huulanka/wisp/hardware/kicad/wisp.kicad_pcb

## KiCad design hardware/kicad/wisp.kicad_pcb (2026-08-08)

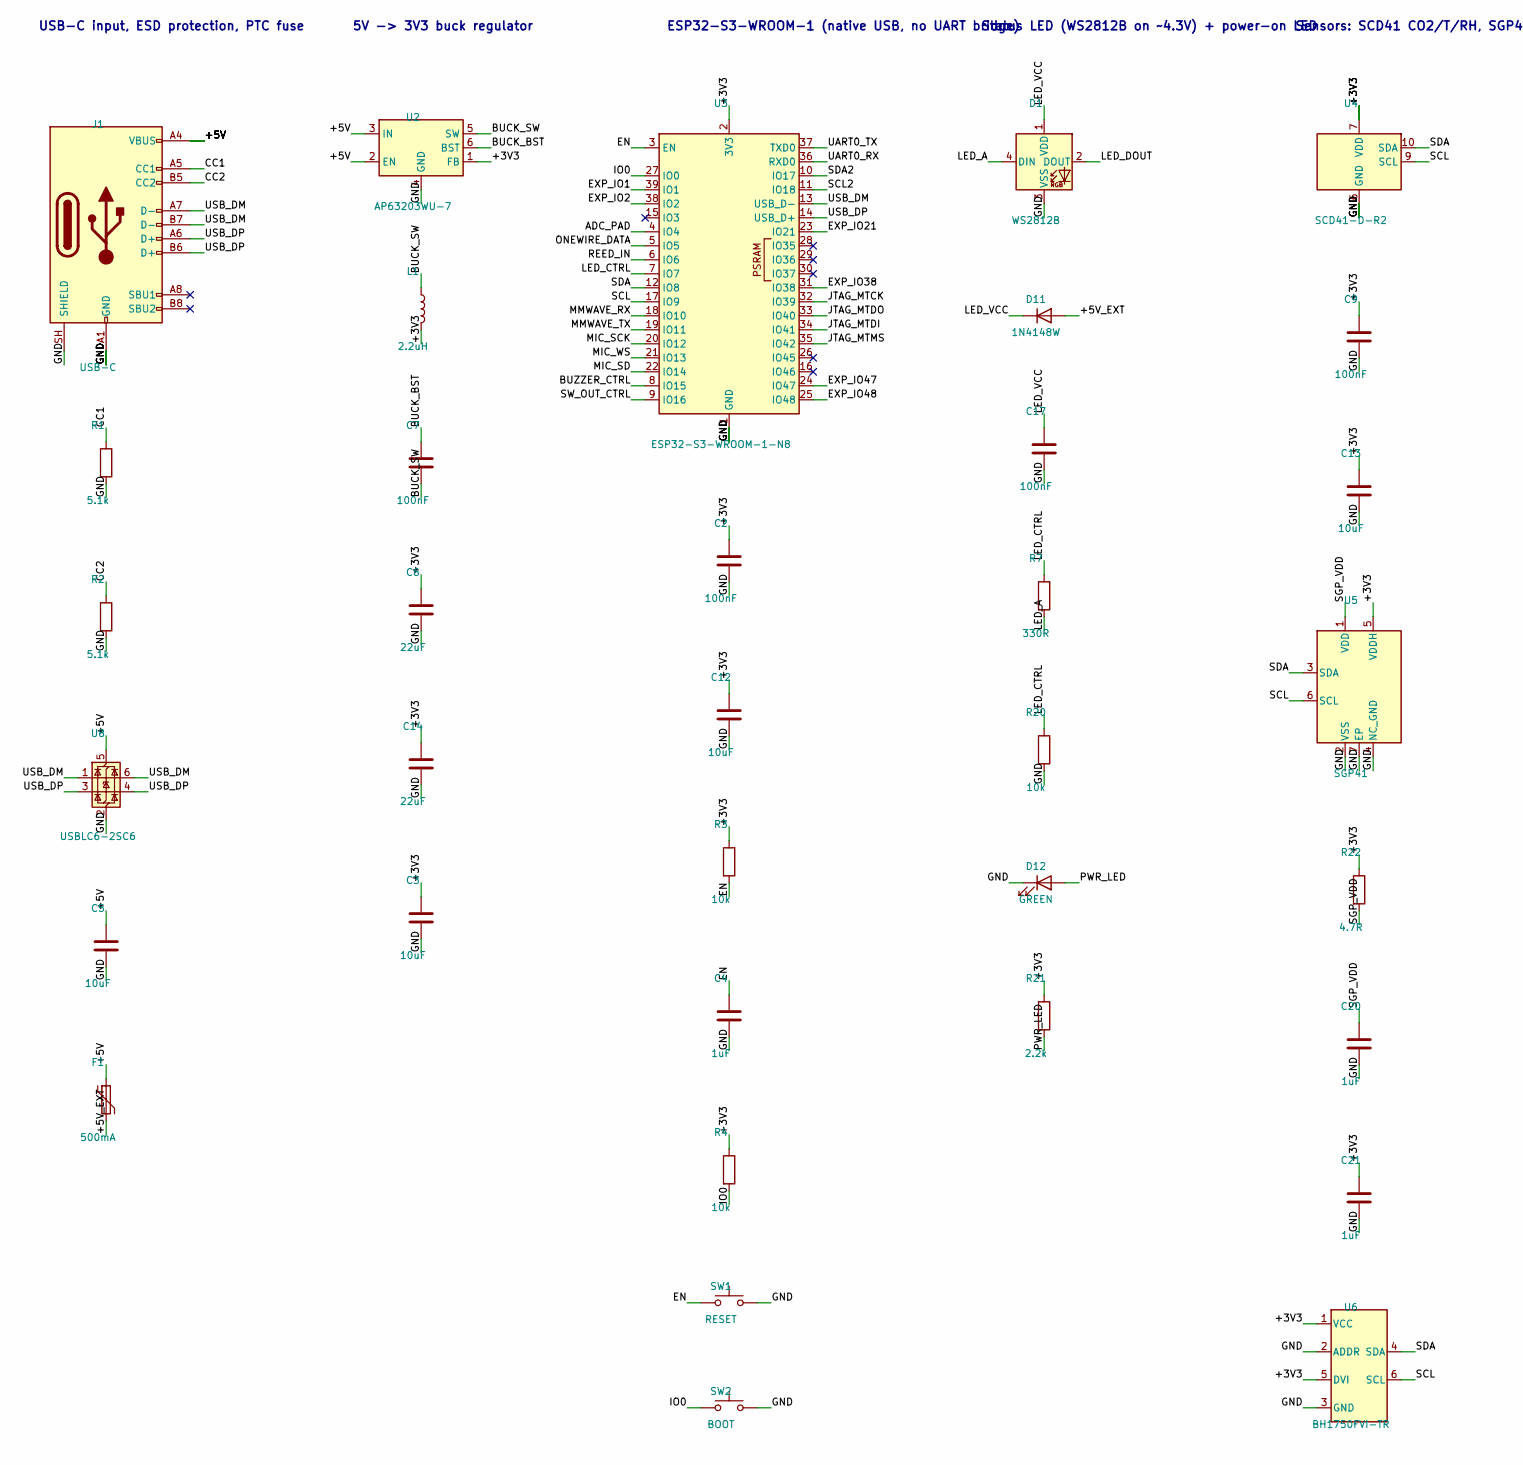
[picture p1: schematic wisp.kicad_sch, part in row 1, column 1]

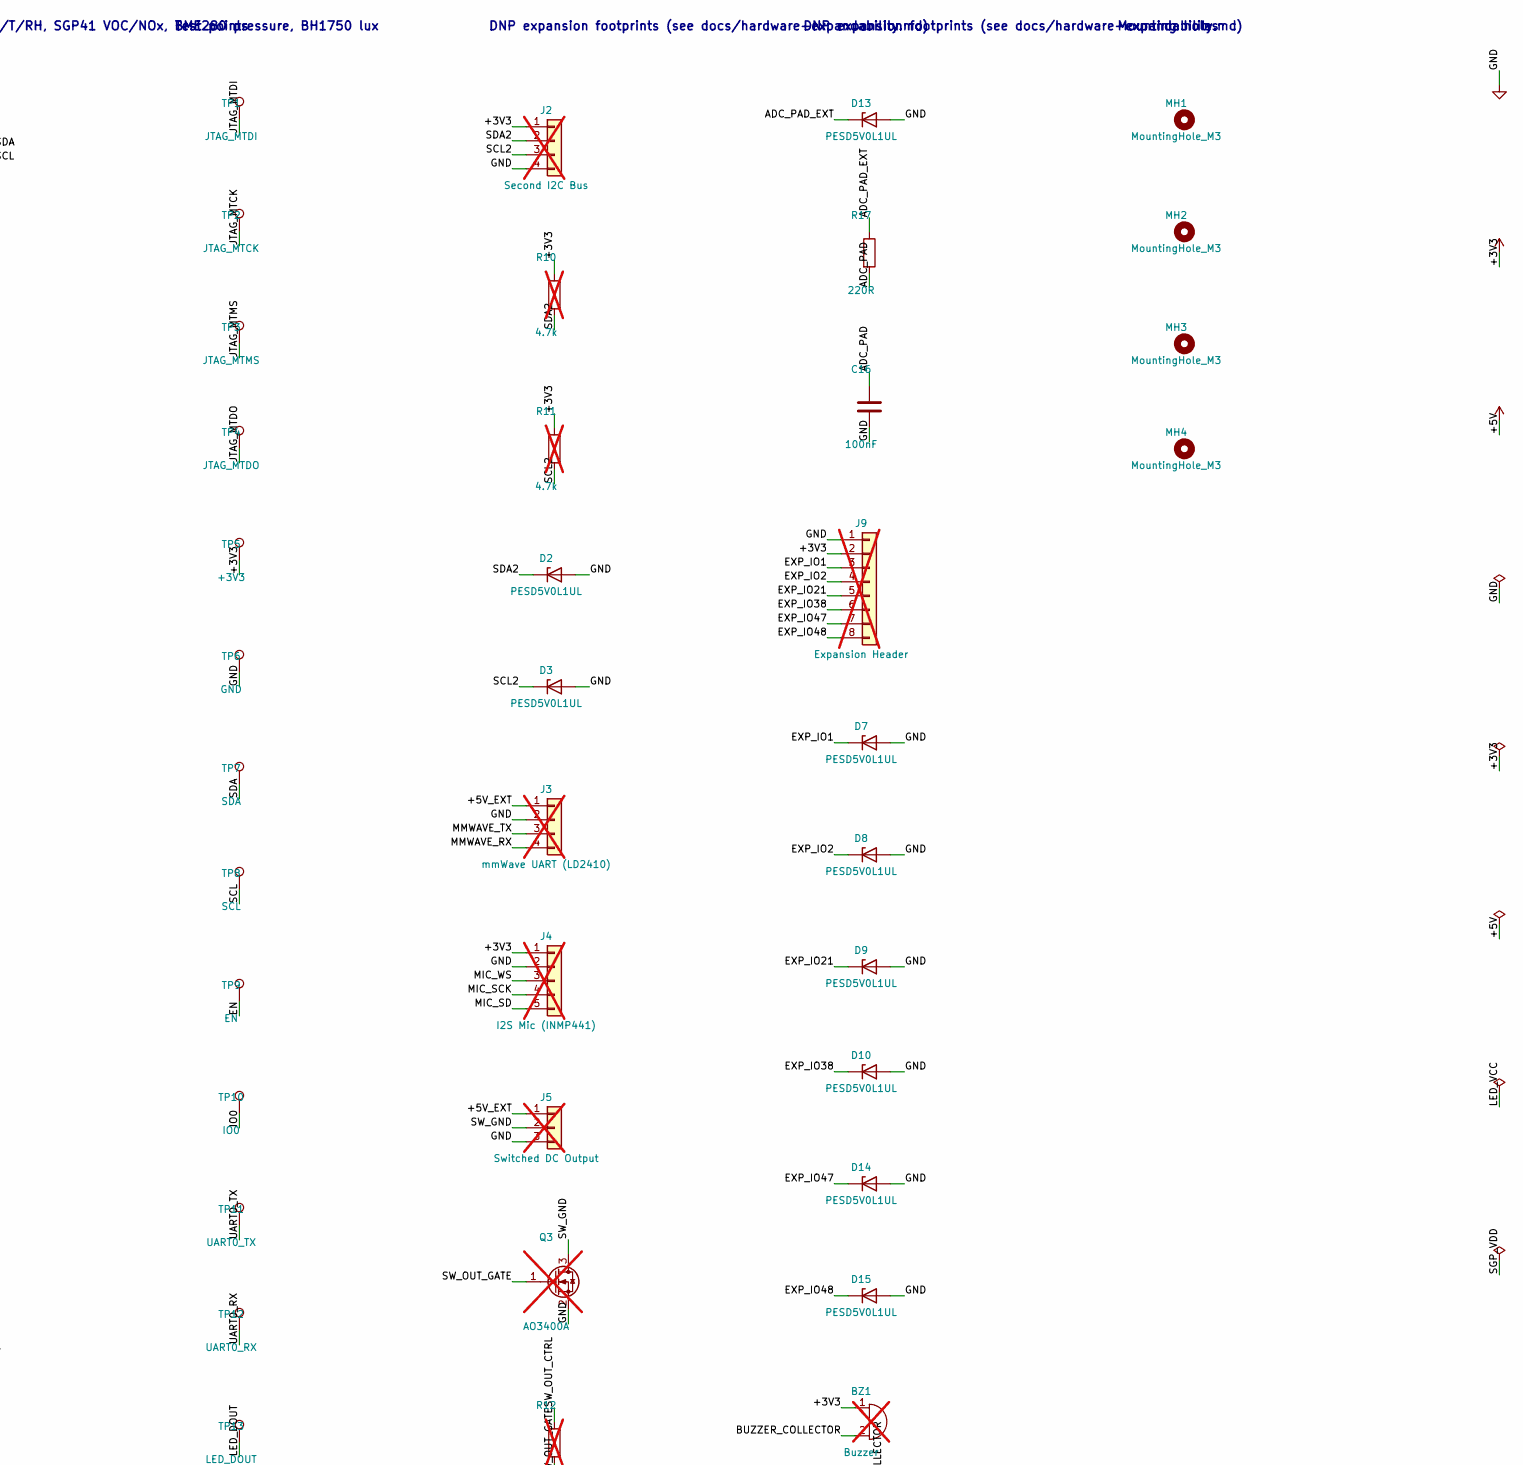
[picture p2: schematic wisp.kicad_sch, part in row 1, column 2]

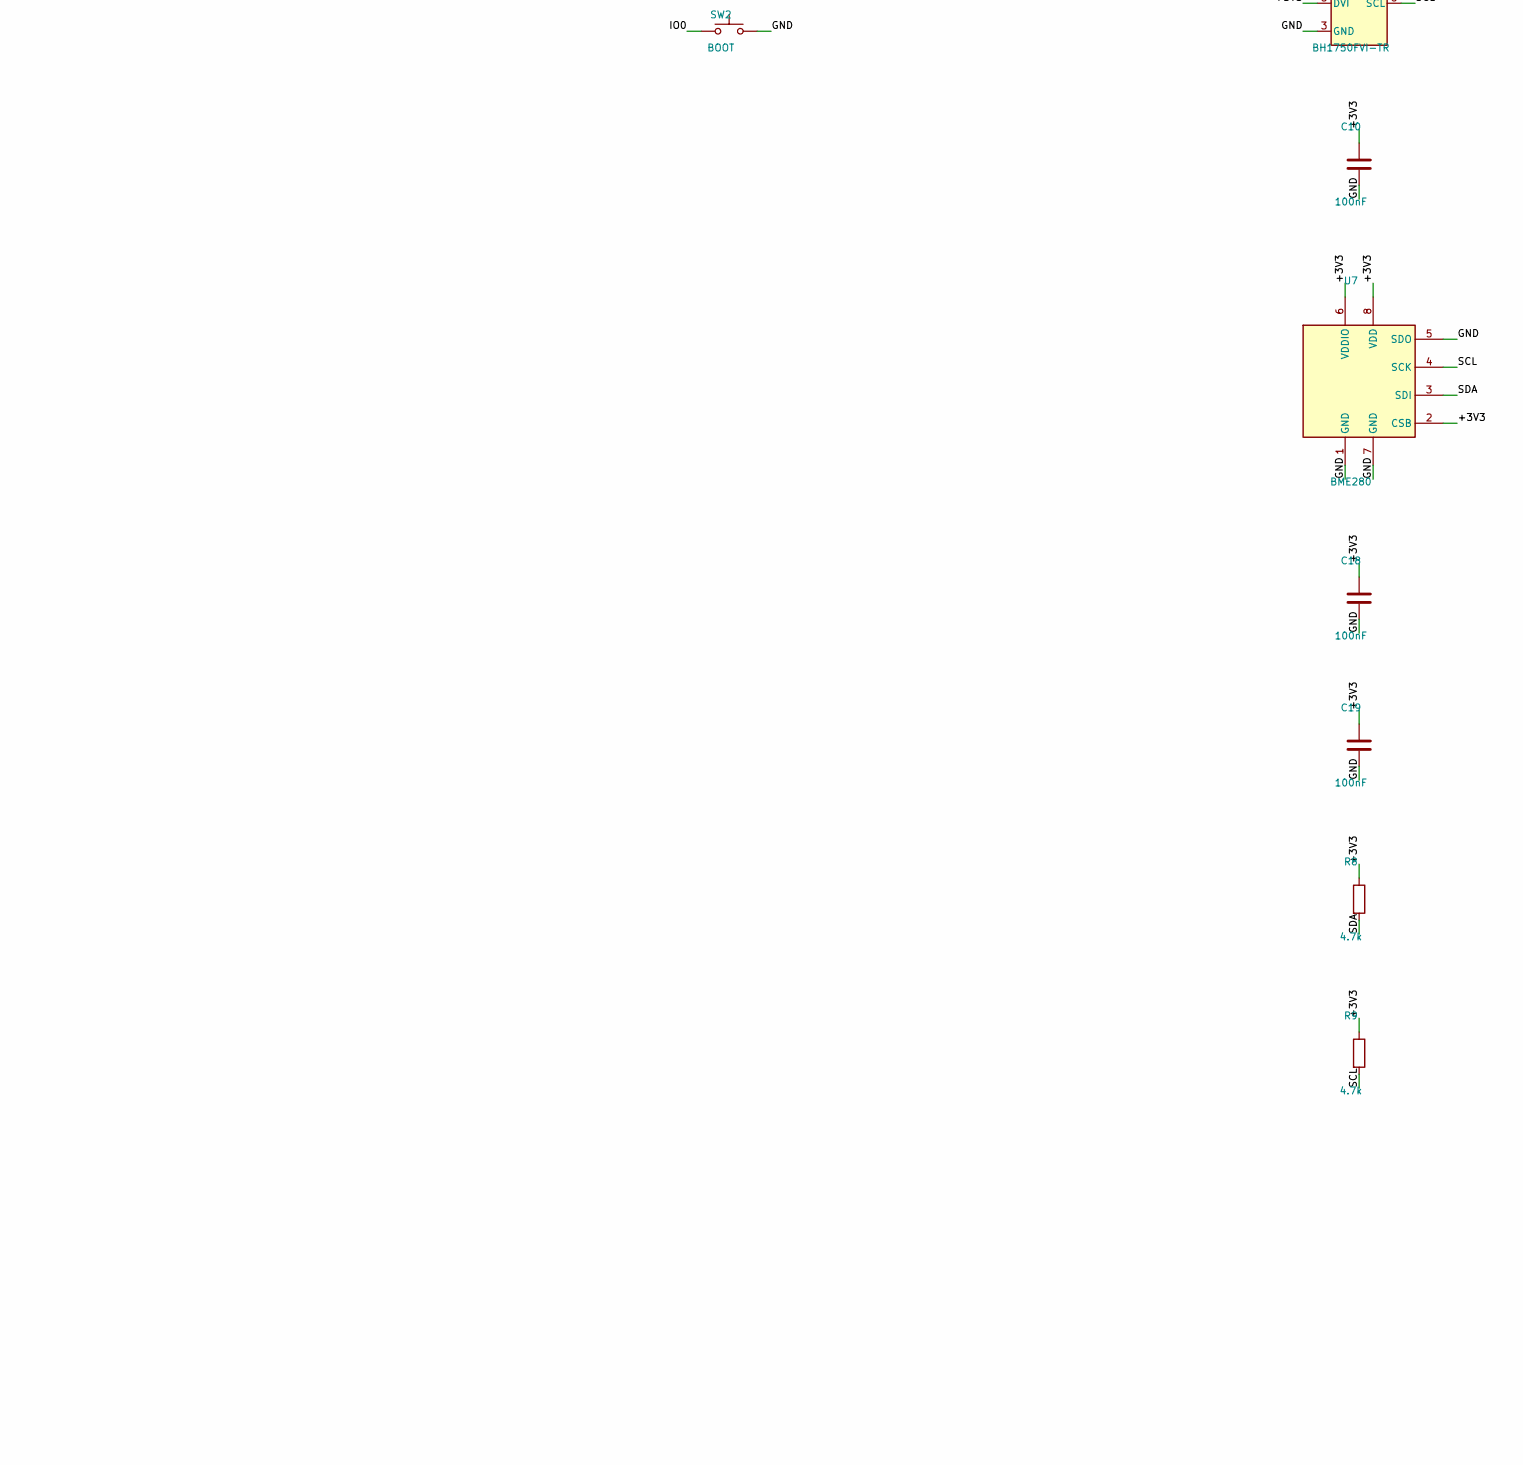
[picture p3: schematic wisp.kicad_sch, part in row 2, column 1]

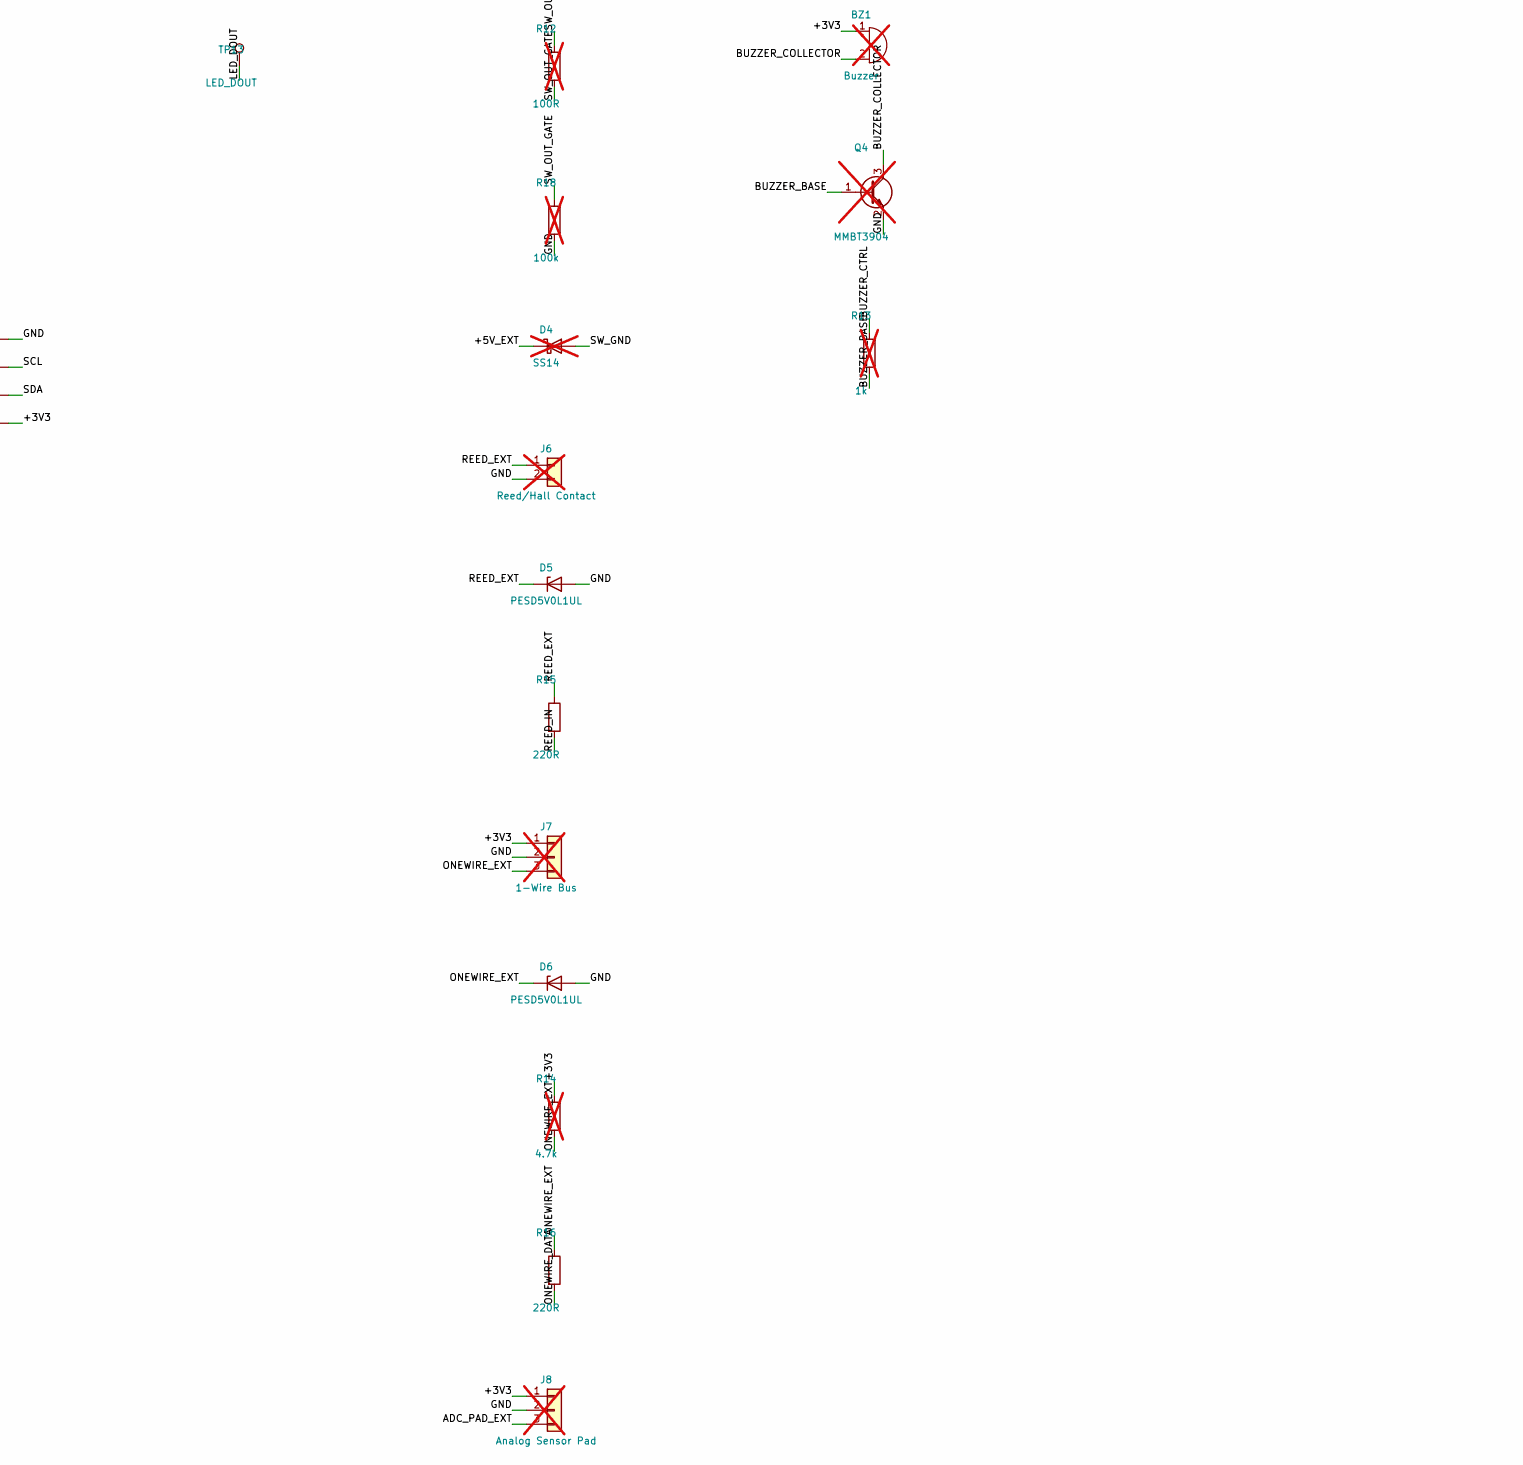
[picture p4: schematic wisp.kicad_sch, part in row 2, column 2]

Parts:
BZ1: Buzzer; Buzzer_CUI_CPT-9019S-SMT; Rating piezo transducer, external drive; MPN CPT-9019S-SMT; not fitted
C2, C7, C9, C10, C17, C18, C19: 100nF; C_0805_2012Metric; Rating 50V X7R; MPN CL21B104KBCNNNC
C3, C12, C13: 10uF; C_0805_2012Metric; Rating 16V X5R; MPN CL21A106KOQNNNE
C4, C20, C21: 1uF; C_0805_2012Metric; Rating 25V X5R; MPN CL21A105KBFNNNE
C5: 10uF; C_0805_2012Metric; Rating 25V X5R; MPN CL21A106KOQNNNE
C6, C14: 22uF; C_0805_2012Metric; Rating 16V X5R; MPN CL21A226MOQNNNE
C16: 100nF; C_0805_2012Metric; Rating 50V X7R, ADC filter; MPN CL21B104KBCNNNC
D1: WS2812B; LED_WS2812B_PLCC4_5.0x5.0mm_P3.2mm; Rating VDD 3.5-5.3V; MPN WS2812B
D2, D3, D5, D6, D7, D8, D9, D10, D13, D14, D15: PESD5V0L1UL; D_SOD-882; MPN PESD5V0L1UL
D4: SS14; D_SMA; Rating Schottky 1A/40V, flyback for the switch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; MPN SS14; not fitted
D11: 1N4148W; D_SOD-123; Rating drops +5V_EXT to ~4.3V for D1; MPN 1N4148W-7-F
D12: GREEN; LED_0805_2012Metric; Rating green, power-on indicator; MPN 150080GS75000
F1: 500mA; Fuse_1206_3216Metric; Rating PTC, 500mA hold, 6V; MPN MF-MSMF050-2
J1: USB-C; USB_C_Receptacle_HRO_TYPE-C-31-M-12; MPN TYPE-C-31-M-12
J2: Second I2C Bus; PinHeader_1x04_P2.54mm_Vertical; not fitted
J3: mmWave UART (LD2410); PinHeader_1x04_P2.54mm_Vertical; not fitted
J4: I2S Mic (INMP441); PinHeader_1x05_P2.54mm_Vertical; not fitted
J5: Switched DC Output; PinHeader_1x03_P2.54mm_Vertical; not fitted
J6: Reed/Hall Contact; PinHeader_1x02_P2.54mm_Vertical; not fitted
J7: 1-Wire Bus; PinHeader_1x03_P2.54mm_Vertical; not fitted
J8: Analog Sensor Pad; PinHeader_1x03_P2.54mm_Vertical; not fitted
J9: Expansion Header; PinHeader_1x08_P2.54mm_Vertical; not fitted
L1: 2.2uH; L_1210_3225Metric; Rating Isat >= 1.5A, DCR < 100mOhm; MPN SRN3015-2R2M
MH1, MH2, MH3, MH4: MountingHole_M3; MountingHole_3.2mm_M3
Q3: AO3400A; SOT-23; Rating logic-level N-FET, 5.7A, Vgs(th) < 1.4V; MPN AO3400A; not fitted
Q4: MMBT3904; SOT-23; MPN MMBT3904; not fitted
R1, R2: 5.1k; R_0805_2012Metric; Rating 1%, 1/8W; MPN RC0805FR-075K1L
R3, R4, R20: 10k; R_0805_2012Metric; Rating 1%, 1/8W; MPN RC0805FR-0710KL
R7: 330R; R_0805_2012Metric; Rating 1%, 1/8W; MPN RC0805FR-07330RL
R8, R9: 4.7k; R_0805_2012Metric; Rating 1%, I2C pull-up; MPN RC0805FR-074K7L
R10, R11: 4.7k; R_0805_2012Metric; Rating 1%; MPN RC0805FR-074K7L; not fitted
R12: 100R; R_0805_2012Metric; Rating 1%, gate series; MPN RC0805FR-07100RL; not fitted
R13: 1k; R_0805_2012Metric; Rating 1%, base series; MPN RC0805FR-071KL; not fitted
R14: 4.7k; R_0805_2012Metric; Rating 1%, 1-Wire pull-up; MPN RC0805FR-074K7L; not fitted
R15, R16, R17: 220R; R_0805_2012Metric; Rating 1%, ESD series; MPN RC0805FR-07220RL
R18: 100k; R_0805_2012Metric; Rating 1%, gate pull-down; MPN RC0805FR-07100KL; not fitted
R21: 2.2k; R_0805_2012Metric; Rating 1%, 1/8W; MPN RC0805FR-072K2L
R22: 4.7R; R_0805_2012Metric; Rating 1%, SGP41 VDD RC element; MPN RC0805FR-074R7L
SW1: RESET; SW_SPST_PTS810; MPN PTS810 SJM 250 SMTR LFS
SW2: BOOT; SW_SPST_PTS810; MPN PTS810 SJM 250 SMTR LFS
TP1: JTAG_MTDI; TestPoint_Pad_1.5x1.5mm
TP2: JTAG_MTCK; TestPoint_Pad_1.5x1.5mm
TP3: JTAG_MTMS; TestPoint_Pad_1.5x1.5mm
TP4: JTAG_MTDO; TestPoint_Pad_1.5x1.5mm
TP5: +3V3; TestPoint_Pad_1.5x1.5mm
TP6: GND; TestPoint_Pad_1.5x1.5mm
TP7: SDA; TestPoint_Pad_1.5x1.5mm
TP8: SCL; TestPoint_Pad_1.5x1.5mm
TP9: EN; TestPoint_Pad_1.5x1.5mm
TP10: IO0; TestPoint_Pad_1.5x1.5mm
TP11: UART0_TX; TestPoint_Pad_1.5x1.5mm
TP12: UART0_RX; TestPoint_Pad_1.5x1.5mm
TP13: LED_DOUT; TestPoint_Pad_1.5x1.5mm
U2: AP63203WU-7; TSOT-23-6; Rating 2A sync buck, fixed 3.3V; MPN AP63203WU-7
U3: ESP32-S3-WROOM-1-N8; ESP32-S3-WROOM-1; Rating 8MB flash, no PSRAM; MPN ESP32-S3-WROOM-1-N8
U4: SCD41-D-R2; Sensirion_SCD4x-1EP_10.1x10.1mm_P1.25mm_EP4.8x4.8mm; Rating CO2/T/RH, I2C 0x62; MPN SCD41-D-R2
U5: SGP41; Sensirion_DFN-6-1EP_2.44x2.44mm_P0.8mm_EP1.25x1.7mm; Rating VOC/NOx, I2C 0x59; MPN SGP41-D-R4
U6: BH1750FVI-TR; BH1750FVI-TR_WSOF6; Rating lux, I2C 0x23; MPN BH1750FVI-TR
U7: BME280; Bosch_LGA-8_2.5x2.5mm_P0.65mm_ClockwisePinNumbering; Rating pressure/T/RH, I2C 0x76; MPN BME280
U8: USBLC6-2SC6; SOT-23-6; Rating ESD array, D+/D-/VBUS; MPN USBLC6-2SC6; LCSC C7519

Connections:
+3V3: BZ1.1 (+), C2.1, C3.1, C6.1, C9.1, C10.1, C12.1, C13.1, C14.1, C18.1, C19.1, C21.1, J2.1, J4.1, J7.1, J8.1, J9.2, L1.2, R3.1, R4.1, R8.1, R9.1, R10.1, R11.1, R14.1, R21.1, R22.1, TP5.1, U2.1 (FB), U3.2 (3V3), U4.7 (VDD), U4.19 (VDD), U5.5 (VDDH), U6.1 (VCC), U6.5 (DVI), U7.2 (CSB), U7.6 (VDDIO), U7.8 (VDD)
+5V: C5.1, F1.1, J1.A4 (VBUS), J1.A9 (VBUS), J1.B4 (VBUS), J1.B9 (VBUS), U2.2 (EN), U2.3 (IN), U8.5 (VBUS)
/+5V_EXT: D4.1 (K), D11.2 (A), F1.2, J3.1, J5.1
/ADC_PAD: C16.1, R17.2, U3.4 (IO4)
/ADC_PAD_EXT: D13.1 (K), J8.3, R17.1
/BUCK_BST: C7.1, U2.6 (BST)
/BUCK_SW: C7.2, L1.1, U2.5 (SW)
/BUZZER_BASE: Q4.1 (B), R13.2
/BUZZER_COLLECTOR: BZ1.2 (-), Q4.3 (C)
/BUZZER_CTRL: R13.1, U3.8 (IO15)
/CC1: J1.A5 (CC1), R1.1
/CC2: J1.B5 (CC2), R2.1
/EN: C4.1, R3.2, SW1.1, TP9.1, U3.3 (EN)
/EXP_IO1: D7.1 (K), J9.3, U3.39 (IO1)
/EXP_IO2: D8.1 (K), J9.4, U3.38 (IO2)
/EXP_IO21: D9.1 (K), J9.5, U3.23 (IO21)
/EXP_IO38: D10.1 (K), J9.6, U3.31 (IO38)
/EXP_IO47: D14.1 (K), J9.7, U3.24 (IO47)
/EXP_IO48: D15.1 (K), J9.8, U3.25 (IO48)
/IO0: R4.2, SW2.1, TP10.1, U3.27 (IO0)
/JTAG_MTCK: TP2.1, U3.32 (IO39)
/JTAG_MTDI: TP1.1, U3.34 (IO41)
/JTAG_MTDO: TP4.1, U3.33 (IO40)
/JTAG_MTMS: TP3.1, U3.35 (IO42)
/LED_A: D1.4 (DIN), R7.2
/LED_CTRL: R7.1, R20.1, U3.7 (IO7)
/LED_DOUT: D1.2 (DOUT), TP13.1
/LED_VCC: C17.1, D1.1 (VDD), D11.1 (K)
/MIC_SCK: J4.4, U3.20 (IO12)
/MIC_SD: J4.5, U3.22 (IO14)
/MIC_WS: J4.3, U3.21 (IO13)
/MMWAVE_RX: J3.4, U3.18 (IO10)
/MMWAVE_TX: J3.3, U3.19 (IO11)
/ONEWIRE_DATA: R16.2, U3.5 (IO5)
/ONEWIRE_EXT: D6.1 (K), J7.3, R14.2, R16.1
/PWR_LED: D12.2 (A), R21.2
/REED_EXT: D5.1 (K), J6.1, R15.1
/REED_IN: R15.2, U3.6 (IO6)
/SCL: R9.2, TP8.1, U3.17 (IO9), U4.9 (SCL), U5.6 (SCL), U6.6 (SCL), U7.4 (SCK)
/SCL2: D3.1 (K), J2.3, R11.2, U3.11 (IO18)
/SDA: R8.2, TP7.1, U3.12 (IO8), U4.10 (SDA), U5.3 (SDA), U6.4 (SDA), U7.3 (SDI)
/SDA2: D2.1 (K), J2.2, R10.2, U3.10 (IO17)
/SGP_VDD: C20.1, R22.2, U5.1 (VDD)
/SW_GND: D4.2 (A), J5.2, Q3.3 (D)
/SW_OUT_CTRL: R12.1, U3.9 (IO16)
/SW_OUT_GATE: Q3.1 (G), R12.2, R18.1
/UART0_RX: TP12.1, U3.36 (RXD0)
/UART0_TX: TP11.1, U3.37 (TXD0)
/USB_DM: J1.A7 (D-), J1.B7 (D-), U3.13 (USB_D-), U8.1 (I/O1), U8.6 (I/O1)
/USB_DP: J1.A6 (D+), J1.B6 (D+), U3.14 (USB_D+), U8.3 (I/O2), U8.4 (I/O2)
GND: C2.2, C3.2, C4.2, C5.2, C6.2, C9.2, C10.2, C12.2, C13.2, C14.2, C16.2, C17.2, C18.2, C19.2, C20.2, C21.2, D1.3 (VSS), D2.2 (A), D3.2 (A), D5.2 (A), D6.2 (A), D7.2 (A), D8.2 (A), D9.2 (A), D10.2 (A), D12.1 (K), D13.2 (A), D14.2 (A), D15.2 (A), J1.A1 (GND), J1.A12 (GND), J1.B1 (GND), J1.B12 (GND), J1.SH (SHIELD), J2.4, J3.2, J4.2, J5.3, J6.2, J7.2, J8.2, J9.1, Q3.2 (S), Q4.2 (E), R1.2, R2.2, R18.2, R20.2, SW1.2, SW2.2, TP6.1, U2.4 (GND), U3.1 (GND), U3.40 (GND), U3.41 (GND), U4.6 (GND), U4.20 (GND), U4.21 (GND), U5.2 (VSS), U5.4 (NC_GND), U5.7 (EP), U6.2 (ADDR), U6.3 (GND), U7.1 (GND), U7.5 (SDO), U7.7 (GND), U8.2 (GND)

Notes on the sheet:
USB-C input, ESD protection, PTC fuse
5V -> 3V3 buck regulator
ESP32-S3-WROOM-1 (native USB, no UART bridge)
Status LED (WS2812B on ~4.3V) + power-on LED
Sensors: SCD41 CO2/T/RH, SGP41 VOC/NOx, BME280 pressure, BH1750 lux
Test points
DNP expansion footprints (see docs/hardware-expandability.md)
Mounting holes

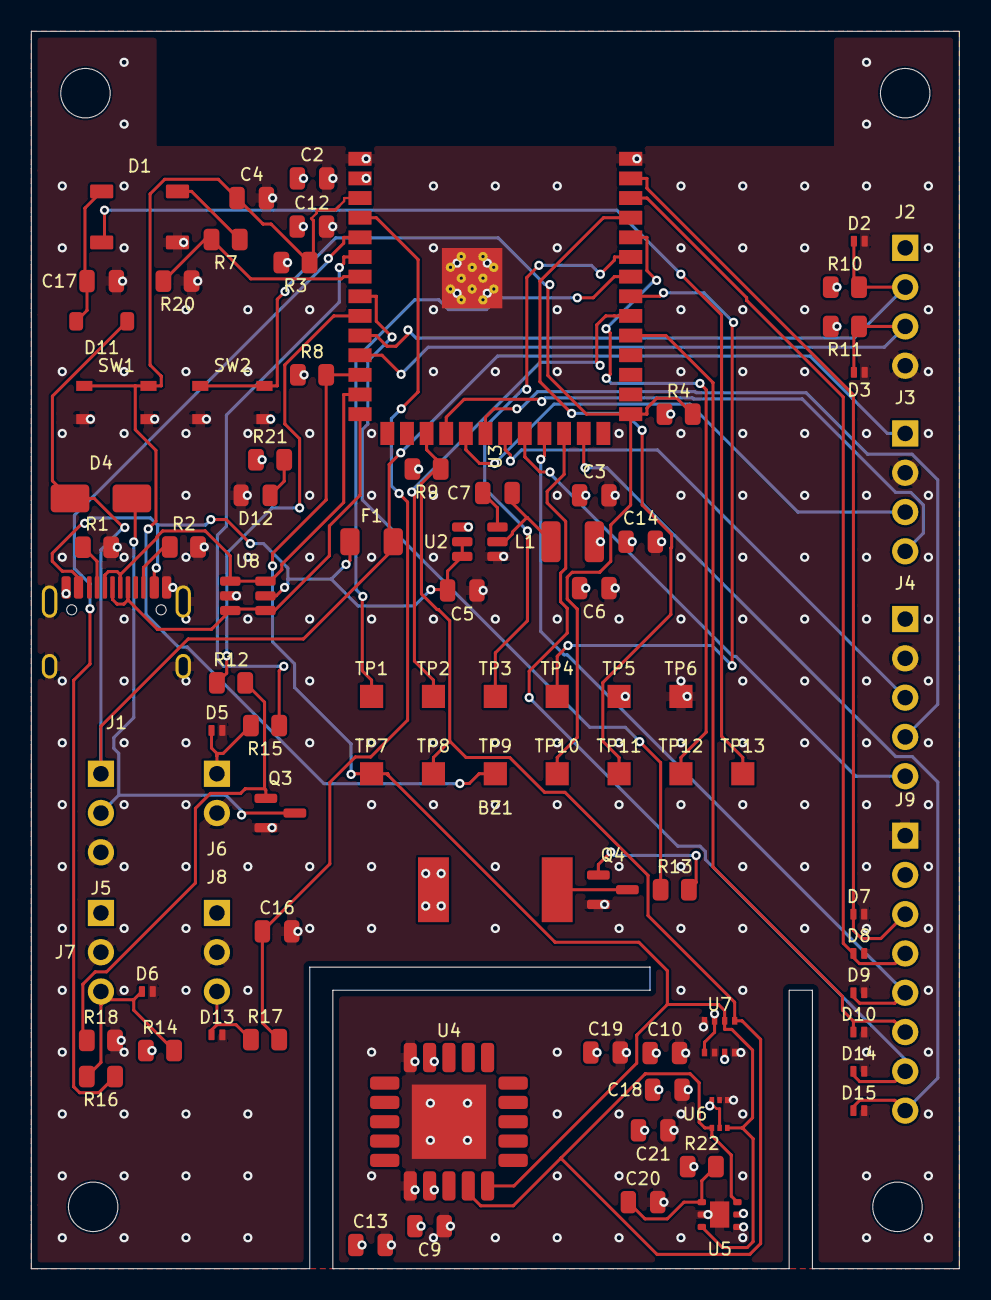
[picture p5: board wisp.kicad_pcb from above]

Board: 4 copper layers, 60.0 x 80.0 mm, 91 parts (0 on the bottom side), 51 nets.
