huulanka/wisp/(commit log)

2026-08-06 Add hardware expandability design-review notes
    Captures the pre-fab expandability discussion: rejected the stackable
    board concept in favor of a single board with DNP footprints/headers,
    records decisions on each candidate feature, a power budget check for
    the buck regulator, and open questions still needing input.
2026-08-06 Add project instructions, concept doc, and first hardware schematic
    Baseline project scaffolding from the previous session that was
    generated but never committed: CLAUDE.md guidance, the design concept
    doc, the KiCad project with the first Wisp board schematic
    (ESP32-WROOM-32, SCD41/BME680/BH1750 sensors, USB-C power/programming),
    and the kicad-check skill.
    [wisp.kicad_sch]
2026-08-06 Add GPIO pin plan, drop PIR and RS485 candidates
    Reads pin usage directly from the schematic netlist (component U3) to
    assign every free ESP32-WROOM-32 GPIO to a DNP feature without
    collisions, and flags the module's internal-flash pins as off-limits.
    PIR and RS485 were considered and dropped per product owner decision.
2026-08-06 Add DNP expansion footprints to schematic per the pin plan
    Implements every accepted expandability item from
    docs/hardware-expandability.md directly in the KiCad schematic:
    - Second isolated I2C bus with its own pull-ups (SDA2/SCL2, IO16/IO17)
    - mmWave presence UART header for LD2410 (IO4/IO5)
    - I2S microphone header for INMP441 (IO25/IO26/IO27)
    - Switched low-voltage DC output via 2N7002 with flyback diode (IO19)
    - Piezo buzzer via NPN driver (IO18)
    - Reed/Hall contact pad (IO23)
    - 1-Wire bus pad with pull-up (IO32)
    - Generic ADC1-capable analog sensor pad (VP/IO36)
    - Generic expansion header, also ADC1-capable (IO33/34/35, VN/IO39)
    - JTAG test points on MTDI/MTCK/MTMS/MTDO (IO12-15)
    - Gen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
    [wisp.kicad_sch]
2026-08-06 Clean up label placement in the new DNP expansion blocks
    Widened spacing between closely-packed new components (I2C pull-ups,
    expansion-header TVS diodes, switched-output cluster) and lengthened
    net-label stubs on header connectors so labels no longer overlap pin
    names or neighboring component text. Also hides the WS2812B footprint
    property text that was leaking into the D1 area.
    Purely cosmetic — re-verified with ERC after each change, same
    pre-existing baseline warnings only, no new errors or net changes.
    [wisp.kicad_sch]
2026-08-06 Clean up label clutter across the whole schematic, not just new parts
    Hides Footprint/Datasheet/Description property text globally (this was
    the single biggest source of clutter -- long strings like
    "Resistor_SMD:R_0805_2012Metric" were rendered directly on the sheet
    for every pre-existing part). Also spreads apart Reference/Value text
    for tightly-packed pre-existing component pairs (R1/R2, C2/C3, R8/R9,
    R3/C4) and the power-flag symbol pairs (#PWR03/06, #PWR01/04,
    #PWR02/05), which were rendered close enough to visually merge.
    Only text/property positions changed -- no component, pin, or wire
    moved, so this cannot affect connectivity. Re-verified with ERC after
    each step: same pre-existing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
    [wisp.kicad_sch]
2026-08-06 Add first-pass PCB layout, fix schematic DNP flags, prep prototype BOM/CPL
    Placement for all 69 schematic parts on a 140x100mm 2-layer board,
    DRC-clean (0 violations): power/USB-C/buck top-left, CH340 + auto-reset
    below it, ESP32-WROOM-32 with its antenna keepout clear near the top
    edge, sensor trio + I2C pull-ups center, DNP expansion headers along the
    right/bottom edges, test-point cluster for bed-of-nails access. GND and
    +3V3 are realized as copper pours (GND stitched with vias); the other 44
    signal nets are left as ratsnest for interactive routing or a real
    autorouter -- not attempted here since a naive single-layer point-to-point
    router produced hundreds of shorts/crossings. Board is no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
    [wisp-bom-full.csv, wisp-bom-prototype.csv, wisp.kicad_pcb, wisp.kicad_sch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]
2026-08-07 Route all 44 signal nets, fix WROOM thermal-via drill size, generate fab Gerbers
    Routed the board with Freerouting (headless, via a fetched jar) for the
    bulk pass, then hand-closed a handful of nets/pour islands that
    Freerouting's dense routing left disconnected, including rip-up/reroute
    of a few local escape traces to free clearance. Also widened U3's
    thermal-via array drill from 0.2mm to 0.3mm — undersized against the
    board's own via_drill rule, previously masked because DRC only surfaces
    that check once real routing exists.
    DRC is 0 violations. One known gap remains: U5 pin 2 (+3V3) sits in a
    fully enclosed pocket with no legal escape given its footprint's 0.8mm
    pitch — documented in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
    [wisp-B_Courtyard.gbr, wisp-B_Cu.gbl, wisp-B_Fab.gbr, wisp-B_Mask.gbs, wisp-B_Paste.gbp, wisp-B_Silkscreen.gbo, wisp-Edge_Cuts.gm1, wisp-F_Courtyard.gbr]
2026-08-07 Close the U5 (+3V3) routing gap left by the last layout pass
    Pin 2 of U5 (BME680) was boxed into a fully enclosed pocket on the top
    layer by its own footprint's 0.8mm pitch neighbors. Turned out worse
    than documented: the bottom layer was blocked at the same spot too, by
    an unrelated /SW_OUT_CTRL trace (R12 to U3 pin 31) crossing directly
    underneath.
    Fix: local dogleg in /SW_OUT_CTRL to clear U5's footprint and escape
    halo (no other constraints along that run), then a via-drop tunnel
    from pin 2, under U5 on the bottom layer, back up to pin 8 (same
    +3V3 net). DRC clean, 0 violations. Gerbers/drill regenerated.
    [wisp-B_Courtyard.gbr, wisp-B_Cu.gbl, wisp-B_Fab.gbr, wisp-B_Mask.gbs, wisp-B_Paste.gbp, wisp-B_Silkscreen.gbo, wisp-Edge_Cuts.gm1, wisp-F_Courtyard.gbr]
2026-08-07 Fix ERC symbol-lib parse bug, move U5 +3V3 via off-pad, document findings
    - wisp.kicad_sym had a stray top-level (embedded_fonts no) field instead of
    one nested per symbol, which made KiCad's parser reject the whole file.
    This was the real cause of ERC reporting the wisp library "not found" for
    U1/U6. Fixed by moving the field into each symbol (ERC: 5 warnings -> 3).
    - Moved the U5 (BME680) pin 2 (+3V3) via off the LGA pad it was sitting in
    (via-in-pad is a reflow solder-wicking risk on a 0.8mm-pitch part with
    only tented, not resin-filled, vias). Required a scoped design-rule
    exception (wisp.kicad_dru) since the board's 0.6mm minimum via can't fit
    off-pad at this pitch, plus c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
    [wisp-B_Cu.gbl, wisp-B_Fab.gbr, wisp-B_Mask.gbs, wisp-B_Paste.gbp, wisp-B_Silkscreen.gbo, wisp-Edge_Cuts.gm1, wisp-F_Cu.gtl, wisp-F_Fab.gbr]
2026-08-07 Update CLAUDE.md to reflect current hardware state
    Hardware is now a routed KiCad project with exported Gerbers/BOM, not
    an empty placeholder directory. Document the wisp.* naming convention,
    the in-place kicad-cli requirement for the local via-size DRC
    exception, and the accepted ERC/DRC baseline in hardware/README.md.
2026-08-07 Compact PCB layout: 140x100mm -> 75x80mm
    Repositioned all 73 footprints into denser functional zones, moved
    roughly half the passives/small-signal parts to the back copper layer,
    and re-routed from scratch with Freerouting (all 44 nets, 0 unrouted).
    - Shrunk U3's (ESP32-WROOM-32) own courtyard from 48x41mm to 19x27mm:
    the imported footprint applied the 15mm Espressif antenna keepout
    symmetrically around the whole module instead of just the antenna
    side. The 15mm clearance now lives on its own dedicated 26x16mm
    keepout zone above the antenna edge instead.
    - Fixed undersized (0.15mm) track segments left by the autorouter.
    - Reduced/hid silkscreen text to resolve overlap findings on th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
    [wisp-B_Courtyard.gbr, wisp-B_Cu.gbl, wisp-B_Fab.gbr, wisp-B_Mask.gbs, wisp-B_Paste.gbp, wisp-B_Silkscreen.gbo, wisp-Edge_Cuts.gm1, wisp-F_Courtyard.gbr]
2026-08-07 Investigate GND/+3V3 pour-stitch gaps (#8), close 1 of 26 with verified routing
    Ran three independent, real-DRC-verified approaches to close the 26
    GND/+3V3 unconnected pour-fill islands from #8:
    - Freerouting on the de-planed full nets: consistently plateaus at
    16+ unrouted connections regardless of pass count -- congestion,
    not a pass-budget problem.
    - Collision-checked candidate-pair search between disconnected copper
    islands (KiCad's own SHAPE_SEGMENT::Collide/GetClearance, not a
    distance heuristic): finds zero viable straight-line path for most
    gaps at any clearance down to 0mm -- direct paths physically overlap
    other nets' copper, they don't just fail clearance.
    - Nudge-an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
    [wisp-B_Courtyard.gbr, wisp-B_Cu.gbl, wisp-B_Fab.gbr, wisp-B_Mask.gbs, wisp-B_Paste.gbp, wisp-B_Silkscreen.gbo, wisp-Edge_Cuts.gm1, wisp-F_Courtyard.gbr]
2026-08-07 Grow board to 100x100mm to close most GND/+3V3 pour-stitch gaps
    Follow-up to #8/#9, which concluded the remaining 25 of 26 unconnected
    GND/+3V3 pour islands at 75x80mm needed a placement change, not more
    routing cleverness. Grew the outline to 100x100mm (JLCPCB's cheapest
    prototype price bracket ceiling, no cost increase), proportionally
    repositioned all 73 footprints, and re-routed from scratch with
    Freerouting.
    Caught and fixed a real bug along the way: naively scaling U3's antenna
    keepout zone (not footprint-owned, so it doesn't move automatically)
    double-transformed it relative to U3, which kicad-cli pcb drc exposed as
    geometrically impossible courtyard-overlap violations against compon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
    [wisp-B_Courtyard.gbr, wisp-B_Cu.gbl, wisp-B_Fab.gbr, wisp-B_Mask.gbs, wisp-B_Paste.gbp, wisp-B_Silkscreen.gbo, wisp-Edge_Cuts.gm1, wisp-F_Courtyard.gbr]
2026-08-07 Close 19 of 26 GND/+3V3 pour-stitch gaps with layer-hop and A* stitching
    Follow-up to the 100x100mm regrow, which left 13 of 26 gaps blocked by
    same-layer signal traces that a same-layer nudge can't route around
    without moving the blocker. Two more collision-verified techniques,
    applied in order:
    - Layer-hop stitching: route the stitch itself onto the opposite copper
    layer for just the colliding segment, via-hopping back down past the
    blocker, instead of moving the blocker. Standard 0.6mm/0.3mm vias
    except directly under U5, which reuses the existing DRU via-size
    exception (0.45mm/0.2mm) since standard vias don't fit its 0.8mm pitch.
    Closed 6 islands.
    - A* pathfinding for the rest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
    [wisp-B_Courtyard.gbr, wisp-B_Cu.gbl, wisp-B_Fab.gbr, wisp-B_Mask.gbs, wisp-B_Paste.gbp, wisp-B_Silkscreen.gbo, wisp-Edge_Cuts.gm1, wisp-F_Courtyard.gbr]
2026-08-08 Rebuild PCB as 4-layer with a functional floorplan; DRC fully clean
    The long-running "unconnected GND/+3V3 pour island" problem (#8) was not a
    routing problem. Three passes tried to stitch the islands shut; this
    replaces the layout that produced them.
    Root causes found:
    - 2-layer stackup where B.Cu was both the ground plane and a routing
    layer. ~1.4m of signal traces plus 40 backside parts shredded it, and
    +3V3 was a second pour competing for F.Cu. Neither power net had a
    reliable path to every pad.
    - Every decoupling capacitor sat on the opposite copper layer, 8-20mm
    from the pin it served (C11 for the ESP32: 11.3mm). The five pads that
    defeated every stitching attempt were exac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
    [wisp-B_Courtyard.gbr, wisp-B_Cu.gbl, wisp-B_Fab.gbr, wisp-B_Mask.gbs, wisp-B_Paste.gbp, wisp-B_Silkscreen.gbo, wisp-Edge_Cuts.gm1, wisp-F_Courtyard.gbr]
2026-08-08 Give the ESP32 a populated bypass cap (C11 is DNP)
    The placement pass assigned C11 to U3 as its 100nF bypass, but C11 is
    flagged DNP in the schematic -- it belongs to the optional expansion
    block. The board would therefore have shipped with no populated local
    decoupling on the ESP32, while the SCD41 got two caps. That is the exact
    defect class this rework set out to fix, so it is worth catching here.
    Swapped the positions of C2 (populated) and C11 (DNP). Both are
    C_0805_2012Metric with identical pad nets and the same rotation, so this
    is a pure relabel: no copper changes, and the existing plane-bonding
    stubs and vias serve the swapped pads unchanged.
    C2 -> U3 pin 2 (+3V3): 1.99mm, popul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
    [wisp-B_Cu.gbl, wisp-B_Mask.gbs, wisp-B_Paste.gbp, wisp-B_Silkscreen.gbo, wisp-Edge_Cuts.gm1, wisp-F_Cu.gtl, wisp-F_Mask.gts, wisp-F_Paste.gtp]
2026-08-08 Rev B: ESP32-S3, open-source VOC sensing, and generated design sources
    Design review of Rev A turned up a board that would not have booted, plus a
    sensor choice that could not be used without a proprietary binary blob. This
    rebuilds the board around both findings.
    The blocker. Rev A's auto-reset circuit drove two grounded-emitter NPNs
    directly from the CH340C's active-low DTR#/RTS# outputs. Those idle HIGH, so
    EN was pulled low whenever the bridge was powered and RTS was not asserted --
    including on a plain USB charger. The board would have sat in reset out of the
    box, and esptool's sequence would have released it only while a port was open.
    Rather than patch that circuit, the MCU moves to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
    [wisp-B_Cu.gbl, wisp-B_Mask.gbs, wisp-B_Paste.gbp, wisp-B_Silkscreen.gbo, wisp-Edge_Cuts.gm1, wisp-F_Cu.gtl, wisp-F_Mask.gts, wisp-F_Paste.gtp]
